Abhinaya-Restek-UNY/MainBoard-Transport-Unlimited2026/MainBoard_Unlimited26/MainBoard_Unlimited26A/MainBoard_Unlimited26A.kicad_pcb

## KiCad design MainBoard_Unlimited26/MainBoard_Unlimited26A/MainBoard_Unlimited26A.kicad_pcb (2026-07-16)

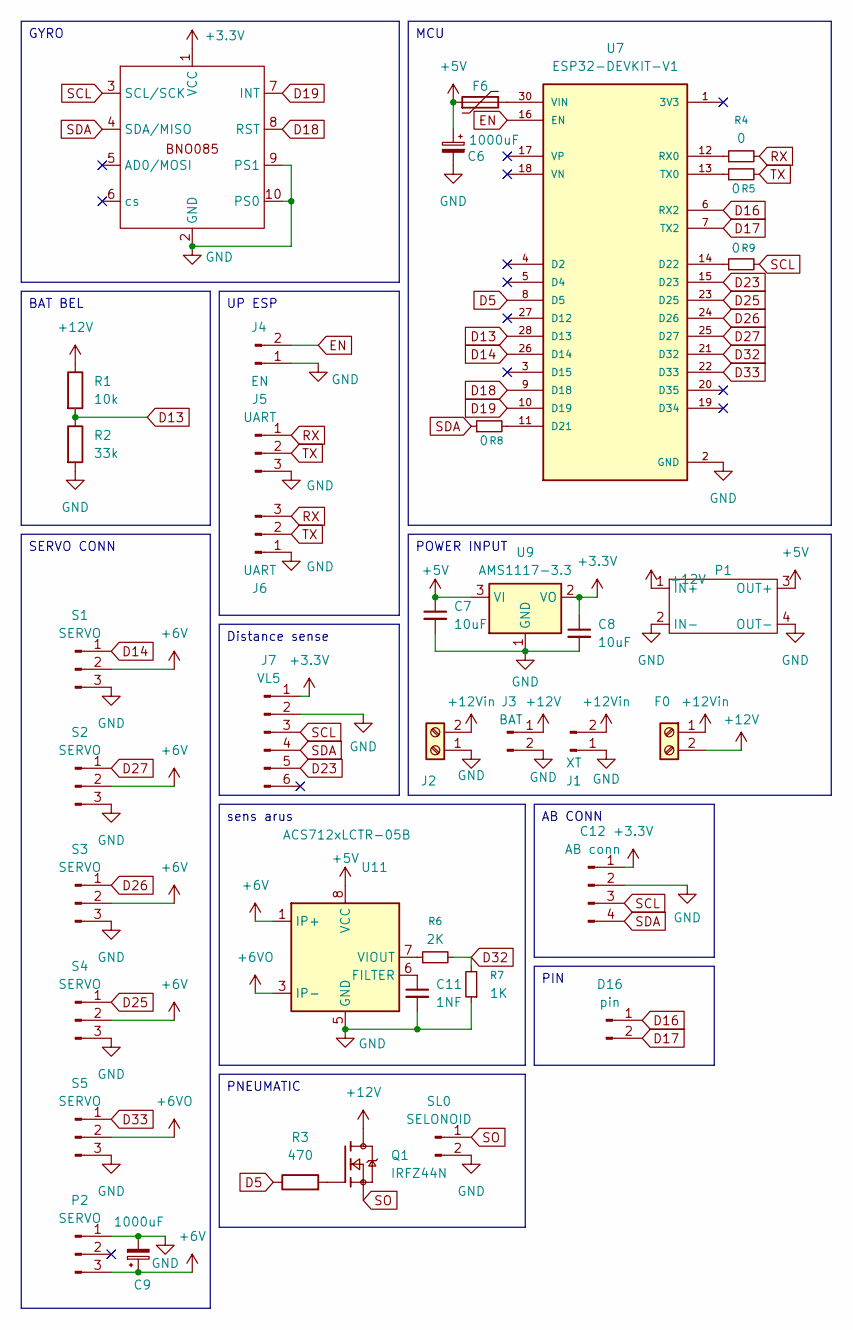
[picture p1: schematic MainBoard_Unlimited26A.kicad_sch]

Parts:
C6, C9: 1000uF; CP_Radial_D10.0mm_P5.00mm
C7, C8: 10uF; C_0805_2012Metric_Pad1.18x1.45mm_HandSolder
C11: 1NF; C_0805_2012Metric_Pad1.18x1.45mm_HandSolder
C12: AB conn; JST_XH_S4B-XH-A-1_1x04_P2.50mm_Horizontal
D16: pin; PinHeader_1x02_P2.54mm_Vertical
F0: Screw_Terminal_01x02; TerminalBlock_MaiXu_MX126-5.0-02P_1x02_P5.00mm
F6: Polyfuse; Fuse_1812_4532Metric
J1: XT; AMASS_XT60-M_1x02_P7.20mm_Vertical
J2: Screw_Terminal_01x02; TerminalBlock_MaiXu_MX126-5.0-02P_1x02_P5.00mm
J3: BAT; JST_XH_B2B-XH-A_1x02_P2.50mm_Vertical
J4: EN; PinHeader_1x02_P2.54mm_Horizontal
J5: UART; PinHeader_1x03_P2.54mm_Horizontal
J6: UART; JST_XH_S3B-XH-A_1x03_P2.50mm_Horizontal
J7: VL5; JST_XH_B6B-XH-A_1x06_P2.50mm_Vertical
P1: MP1584_Module
P2: SERVO; JST_XH_B3B-XH-A_1x03_P2.50mm_Vertical
Q1: IRFZ44N; TO254P1016X419X2286-3; PARTREV 09/21/10
R1: 10k; R_1206_3216Metric_Pad1.30x1.75mm_HandSolder
R2: 33k; R_0805_2012Metric_Pad1.20x1.40mm_HandSolder
R3: 470; R_1206_3216Metric_Pad1.30x1.75mm_HandSolder
R4, R5, R8, R9: 0; R_1206_3216Metric_Pad1.30x1.75mm_HandSolder
R6: 2K; R_0805_2012Metric_Pad1.20x1.40mm_HandSolder
R7: 1K; R_0805_2012Metric_Pad1.20x1.40mm_HandSolder
S1, S2, S3, S4, S5: SERVO; JST_XH_B3B-XH-A_1x03_P2.50mm_Vertical
SL0: SELONOID; JST_XH_B2B-XH-A_1x02_P2.50mm_Vertical
U7: ESP32-DEVKIT-V1; MODULE_ESP32_DEVKIT_V1; PARTREV N/A
U8: MPU6050/BNO085 I2C; PinSocket_1x10_P2.54mm_Vertical
U9: AMS1117-3.3; SOT-223-3_TabPin2
U11: ACS712xLCTR-05B; SOIC-8_3.9x4.9mm_P1.27mm

Connections:
+3.3V: C8.1, C12.1, J7.1, U8.1 (VCC), U9.2 (VO)
+5V: C6.1, C7.1, F6.1, P1.3 (OUT+), U9.3 (VI), U11.8 (VCC)
+6V: C9.1, P2.3, S1.2, S2.2, S3.2, S4.2, U11.1 (IP+), U11.2 (IP+)
+6VO: S5.2, U11.3 (IP-), U11.4 (IP-)
+12V: F0.2, J3.1, P1.1 (IN+), Q1.2, R1.1
+12Vin: F0.1, J1.2, J2.2
D5: R3.1, U7.8 (D5)
D13: R1.2, R2.1, U7.28 (D13)
D14: S1.1, U7.26 (D14)
D16: D16.1, U7.6 (RX2)
D17: D16.2, U7.7 (TX2)
D18: U7.9 (D18), U8.8 (RST)
D19: U7.10 (D19), U8.7 (INT)
D23: J7.5, U7.15 (D23)
D25: S4.1, U7.23 (D25)
D26: S3.1, U7.24 (D26)
D27: S2.1, U7.25 (D27)
D32: R6.2, R7.2, U7.21 (D32)
D33: S5.1, U7.22 (D33)
EN: J4.2, U7.16 (EN)
GND: C6.2, C7.2, C8.2, C9.2, C11.2, C12.2, J1.1, J2.1, J3.2, J4.1, J5.3, J6.1, J7.2, P1.2 (IN-), P1.4 (OUT-), P2.1, R2.2, R7.1, S1.3, S2.3, S3.3, S4.3, S5.3, SL0.2, U7.2 (GND), U7.29 (GND), U8.2 (GND), U8.9 (PS1), U8.10 (PS0), U9.1 (GND), U11.5 (GND)
unnamed: Q1.1, R3.2
unnamed: R8.2, U7.11 (D21)
unnamed: R9.1, U7.14 (D22)
unnamed: R4.1, U7.12 (RX0)
unnamed: R5.1, U7.13 (TX0)
unnamed: F6.2, U7.30 (VIN)
unnamed: C11.1, U11.6 (FILTER)
unnamed: R6.1, U11.7 (VIOUT)
RX: J5.1, J6.3, R4.2
SCL: C12.3, J7.3, R9.2, U8.3 (SCL/SCK)
SDA: C12.4, J7.4, R8.1, U8.4 (SDA/MISO)
SO: Q1.3, SL0.1
TX: J5.2, J6.2, R5.2

Notes on the sheet:
AB CONN
PIN
UP ESP
PNEUMATIC
sens arus
POWER INPUT
MCU
BAT BEL
Distance sense
GYRO
SERVO CONN

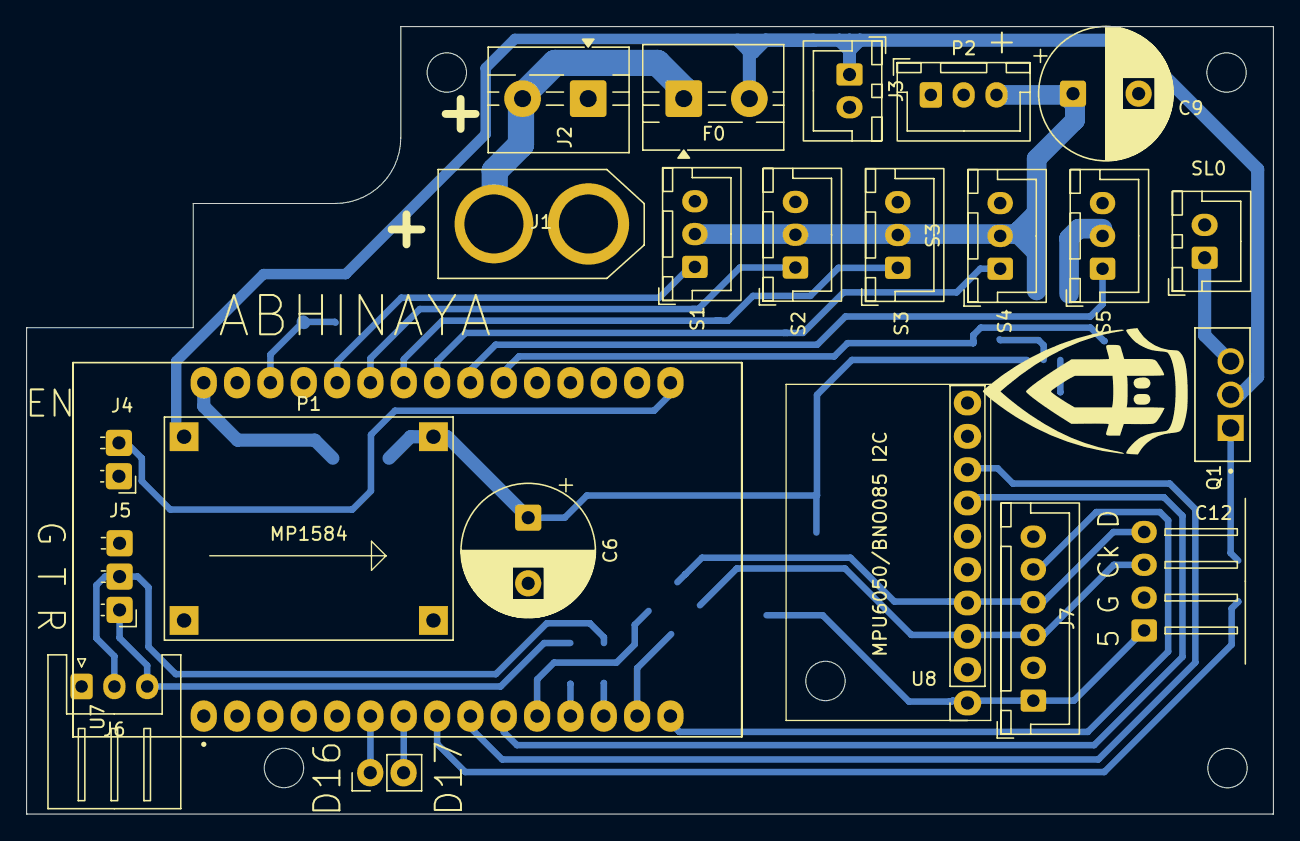
[picture p2: board MainBoard_Unlimited26A.kicad_pcb from above]

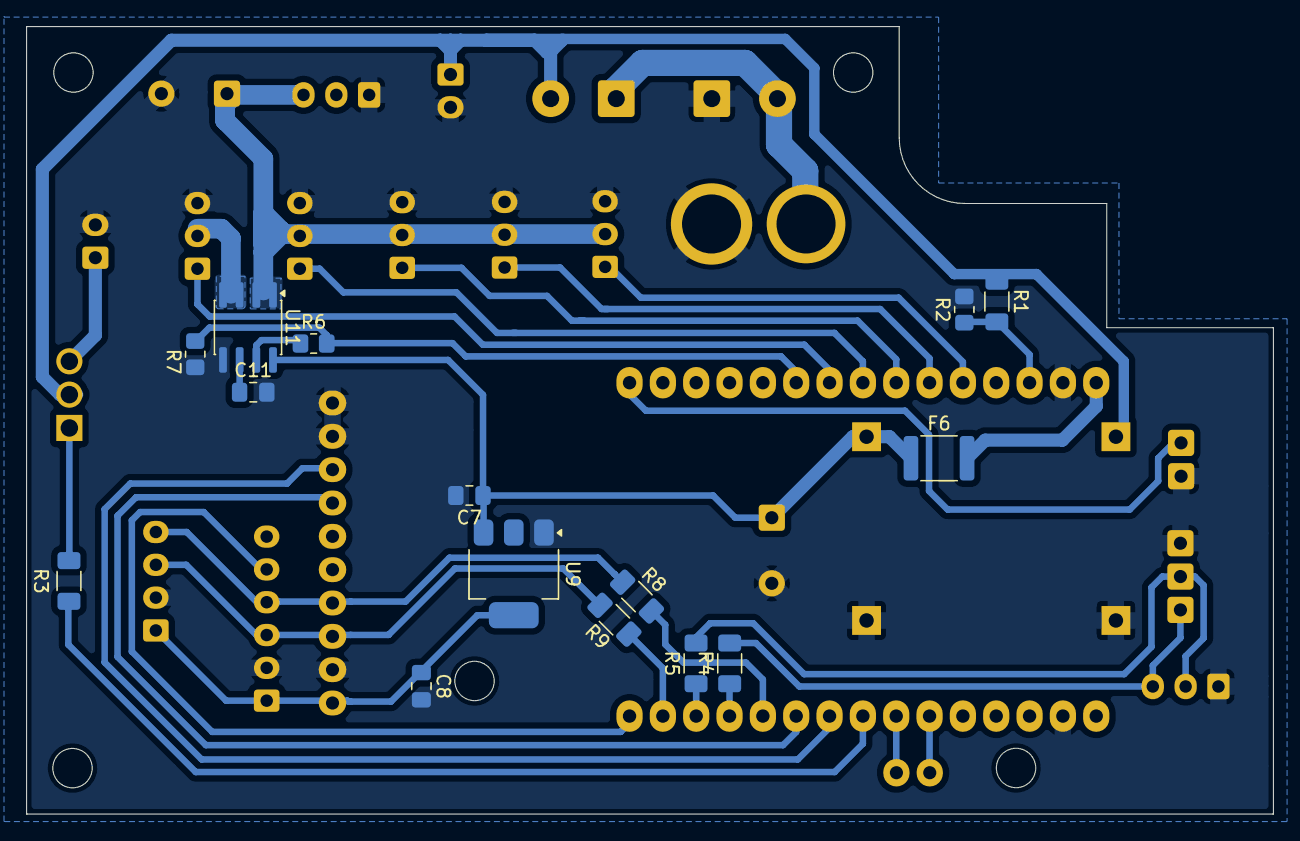
[picture p3: board MainBoard_Unlimited26A.kicad_pcb from below]

Board: 2 copper layers, 95.0 x 60.0 mm, 38 parts (15 on the bottom side), 34 nets.
