Abhinaya-Restek-UNY/MainBoard-Transport-Unlimited2026/MainBoard_Unlimited26/MainBoard_Unlimited26B/MainBoard_Unlimited26B.kicad_pcb

## KiCad design MainBoard_Unlimited26/MainBoard_Unlimited26B/MainBoard_Unlimited26B.kicad_pcb (2026-07-16)

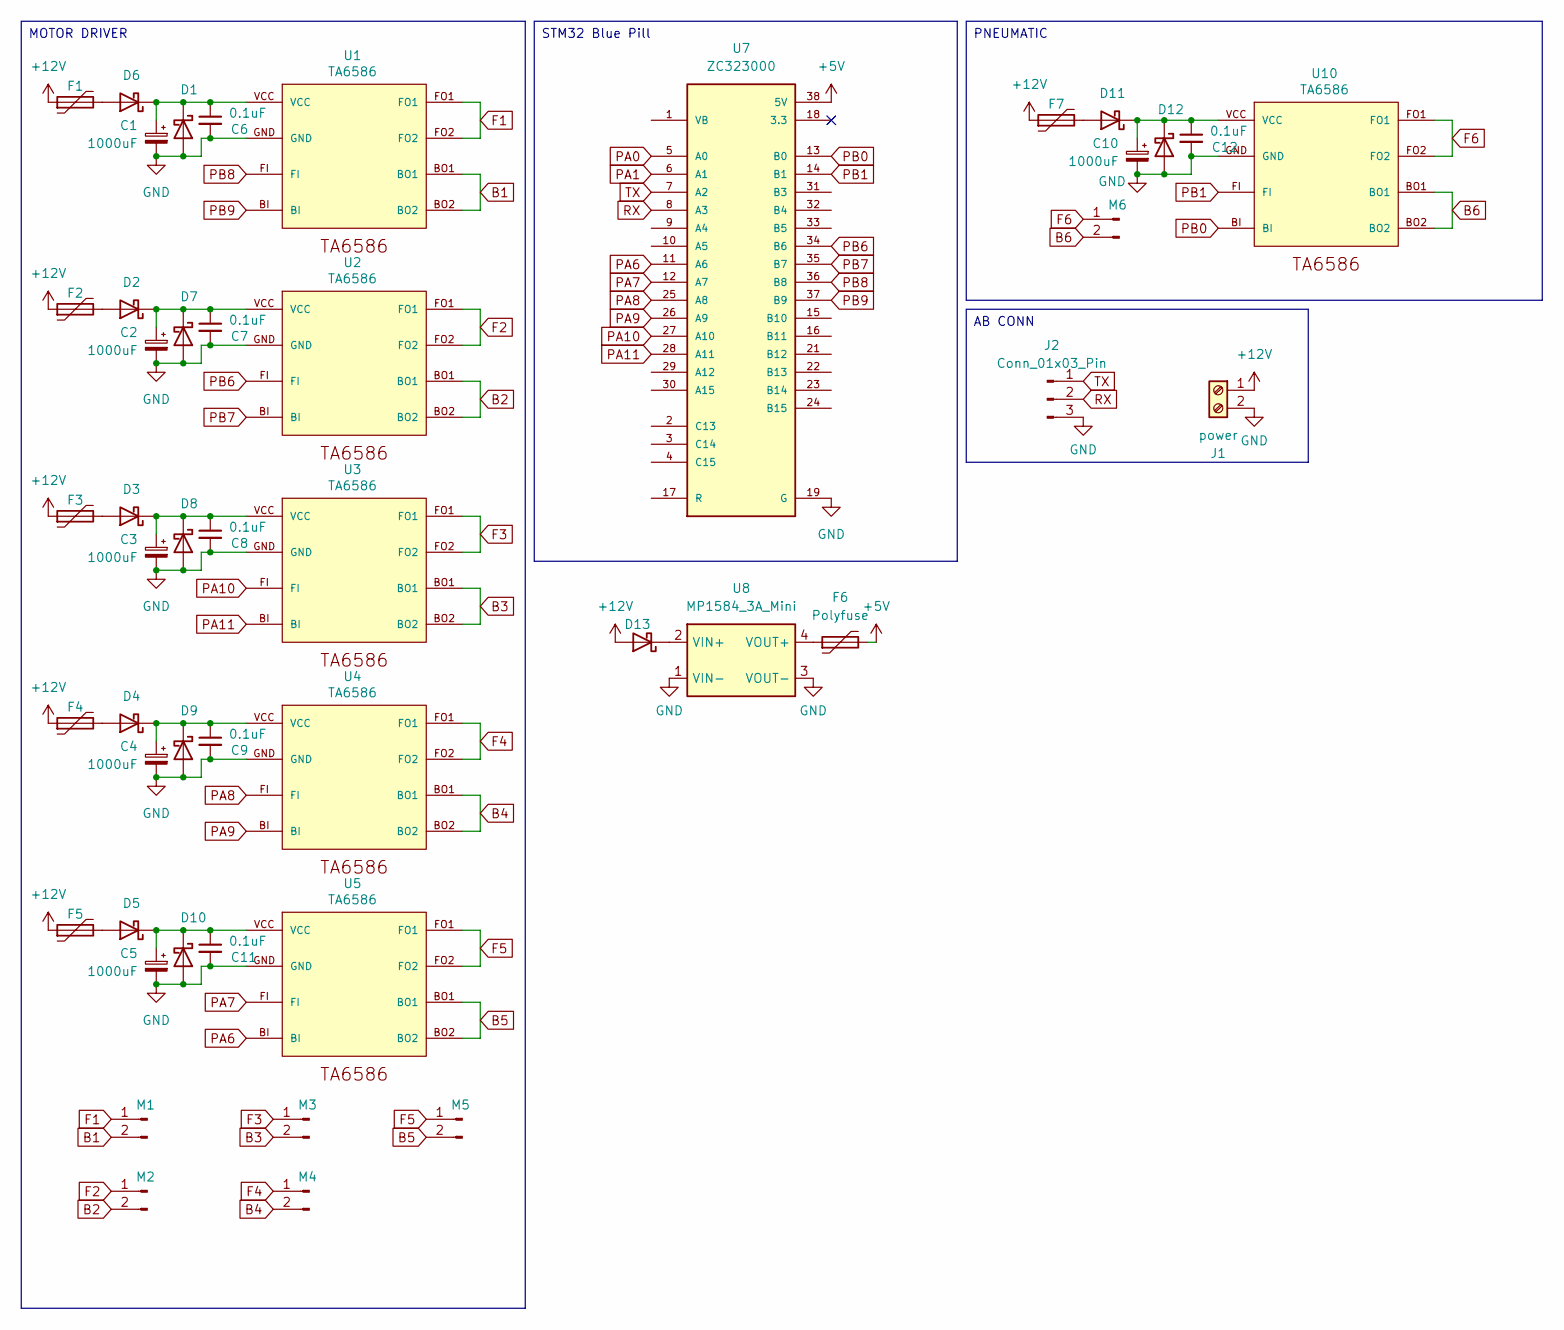
[picture p4: schematic MainBoard_Unlimited26B.kicad_sch]

Parts:
C1, C2, C3, C4, C5, C10: 1000uF; CP_Radial_D10.0mm_P5.00mm
C6, C7, C8, C9, C11, C12: 0.1uF; C_0805_2012Metric_Pad1.18x1.45mm_HandSolder
D1, D2, D3, D4, D5, D6, D7, D8, D9, D10, D11, D12, D13: D_Schottky; D_SMA
F1, F2, F3, F4, F5, F7: Polyfuse; Fuse_Bourns_MF-RG300
F6: Polyfuse; Fuse_1812_4532Metric
J1: power; TE_282815-2
J2: Conn_01x03_Pin; JST_XH_B3B-XH-A_1x03_P2.50mm_Vertical
M1, M2, M3, M4, M5, M6: JST_XH_S2B-XH-A-1_1x02_P2.50mm_Horizontal
U1, U2, U3, U4, U5, U10: TA6586; TA6586-FOOTPRINT
U7: ZC323000; MODULE_ZC323000; PARTREV N/A
U8: MP1584_3A_Mini; Mini360

Connections:
+5V: F6.2, U7.38 (5V)
+12V: D13.2 (A), F1.1, F2.1, F3.1, F4.1, F5.1, F7.1, J1.1
B1: M1.2, U1.BO1, U1.BO2
B2: M2.2, U2.BO1, U2.BO2
B3: M3.2, U3.BO1, U3.BO2
B4: M4.2, U4.BO1, U4.BO2
B5: M5.2, U5.BO1, U5.BO2
B6: M6.2, U10.BO1, U10.BO2
F1: M1.1, U1.FO1, U1.FO2
F2: M2.1, U2.FO1, U2.FO2
F3: M3.1, U3.FO1, U3.FO2
F4: M4.1, U4.FO1, U4.FO2
F5: M5.1, U5.FO1, U5.FO2
F6: M6.1, U10.FO1, U10.FO2
GND: C1.2, C2.2, C3.2, C4.2, C5.2, C6.2, C7.2, C8.2, C9.2, C10.2, C11.2, C12.2, D1.2 (A), D7.2 (A), D8.2 (A), D9.2 (A), D10.2 (A), D12.2 (A), J1.2, J2.3, U1.GND, U2.GND, U3.GND, U4.GND, U5.GND, U7.19 (G), U7.20 (G), U7.39 (G), U8.1 (VIN-), U8.3 (VOUT-), U10.GND
unnamed: C1.1, C6.1, D1.1 (K), D6.1 (K), U1.VCC
unnamed: D2.2 (A), F2.2
unnamed: C2.1, C7.1, D2.1 (K), D7.1 (K), U2.VCC
unnamed: D3.2 (A), F3.2
unnamed: C3.1, C8.1, D3.1 (K), D8.1 (K), U3.VCC
unnamed: D4.2 (A), F4.2
unnamed: C4.1, C9.1, D4.1 (K), D9.1 (K), U4.VCC
unnamed: D5.2 (A), F5.2
unnamed: D6.2 (A), F1.2
unnamed: C5.1, C11.1, D5.1 (K), D10.1 (K), U5.VCC
unnamed: D11.2 (A), F7.2
unnamed: C10.1, C12.1, D11.1 (K), D12.1 (K), U10.VCC
unnamed: D13.1 (K), U8.2 (VIN+)
unnamed: F6.1, U8.4 (VOUT+)
PA0: U7.5 (A0)
PA1: U7.6 (A1)
PA6: U5.BI, U7.11 (A6)
PA7: U5.FI, U7.12 (A7)
PA8: U4.FI, U7.25 (A8)
PA9: U4.BI, U7.26 (A9)
PA10: U3.FI, U7.27 (A10)
PA11: U3.BI, U7.28 (A11)
PB0: U7.13 (B0), U10.BI
PB1: U7.14 (B1), U10.FI
PB6: U2.FI, U7.34 (B6)
PB7: U2.BI, U7.35 (B7)
PB8: U1.FI, U7.36 (B8)
PB9: U1.BI, U7.37 (B9)
RX: J2.2, U7.8 (A3)
TX: J2.1, U7.7 (A2)

Notes on the sheet:
PNEUMATIC
AB CONN
MOTOR DRIVER
STM32 Blue Pill

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
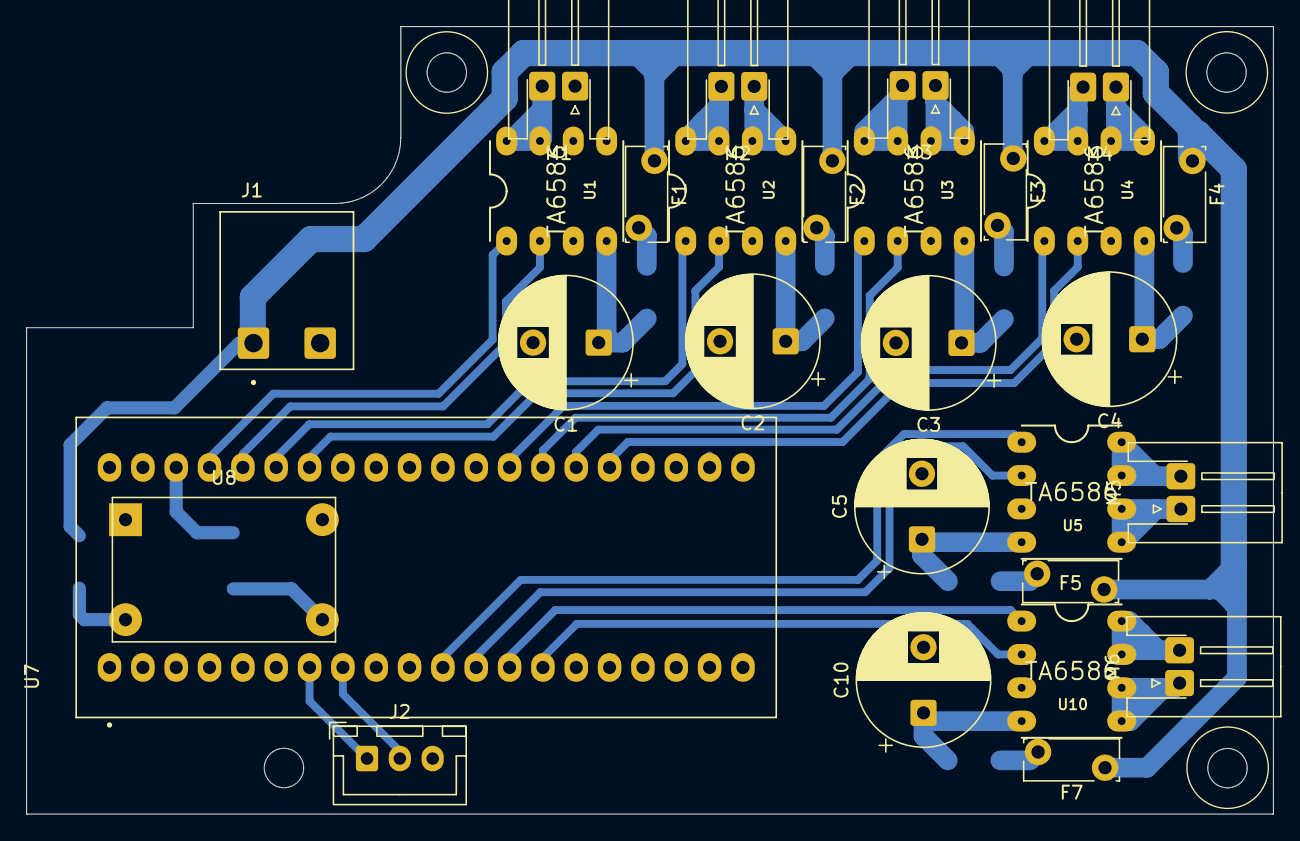
[picture p5: board MainBoard_Unlimited26B.kicad_pcb from above]

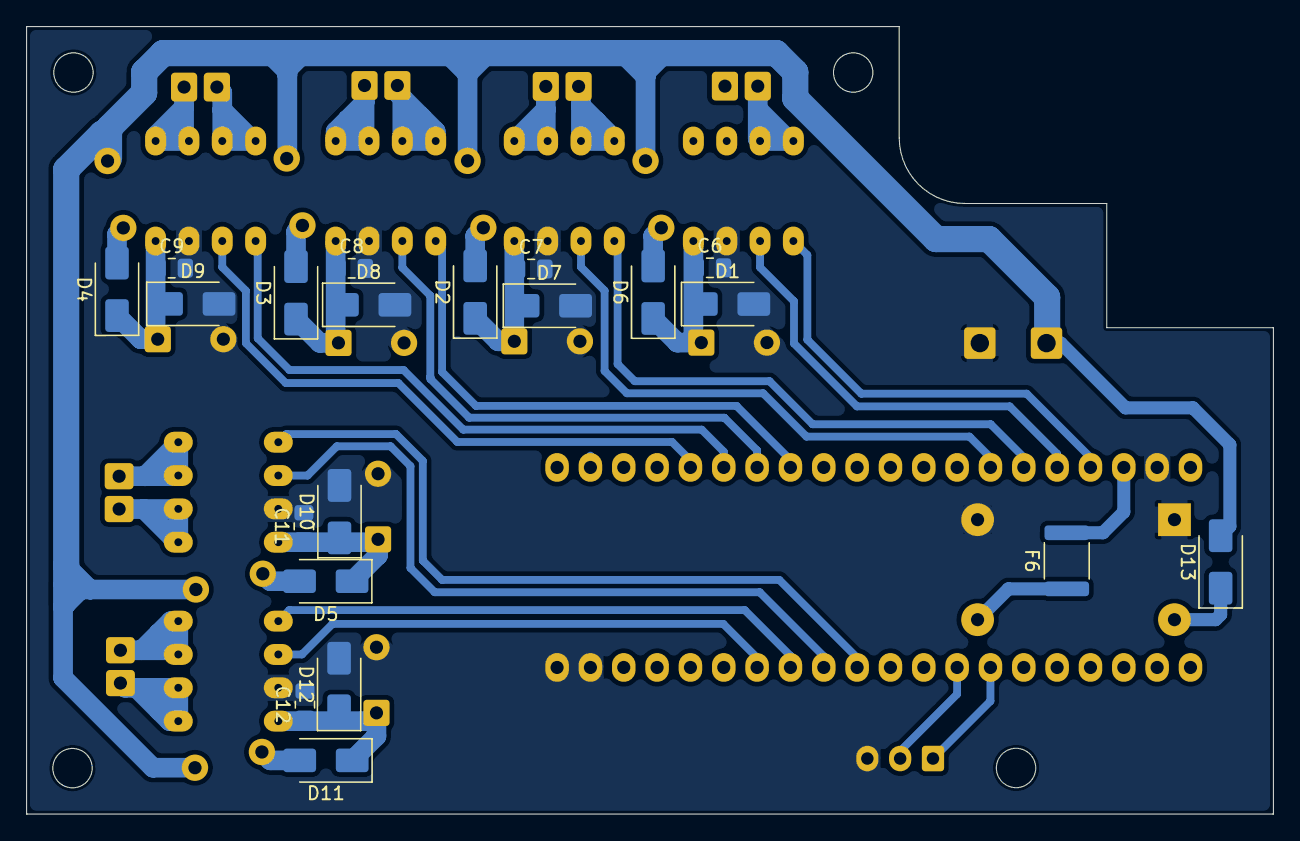
[picture p6: board MainBoard_Unlimited26B.kicad_pcb from below]

Board: 2 copper layers, 95.0 x 60.0 mm, 48 parts (20 on the bottom side), 43 nets.
