Abhinaya-Restek-UNY/MainBoard-Transport-Unlimited2026/esp32-cam_holder/esp32-cam_holder.kicad_pcb

## KiCad design esp32-cam_holder/esp32-cam_holder.kicad_pcb (2026-07-10)

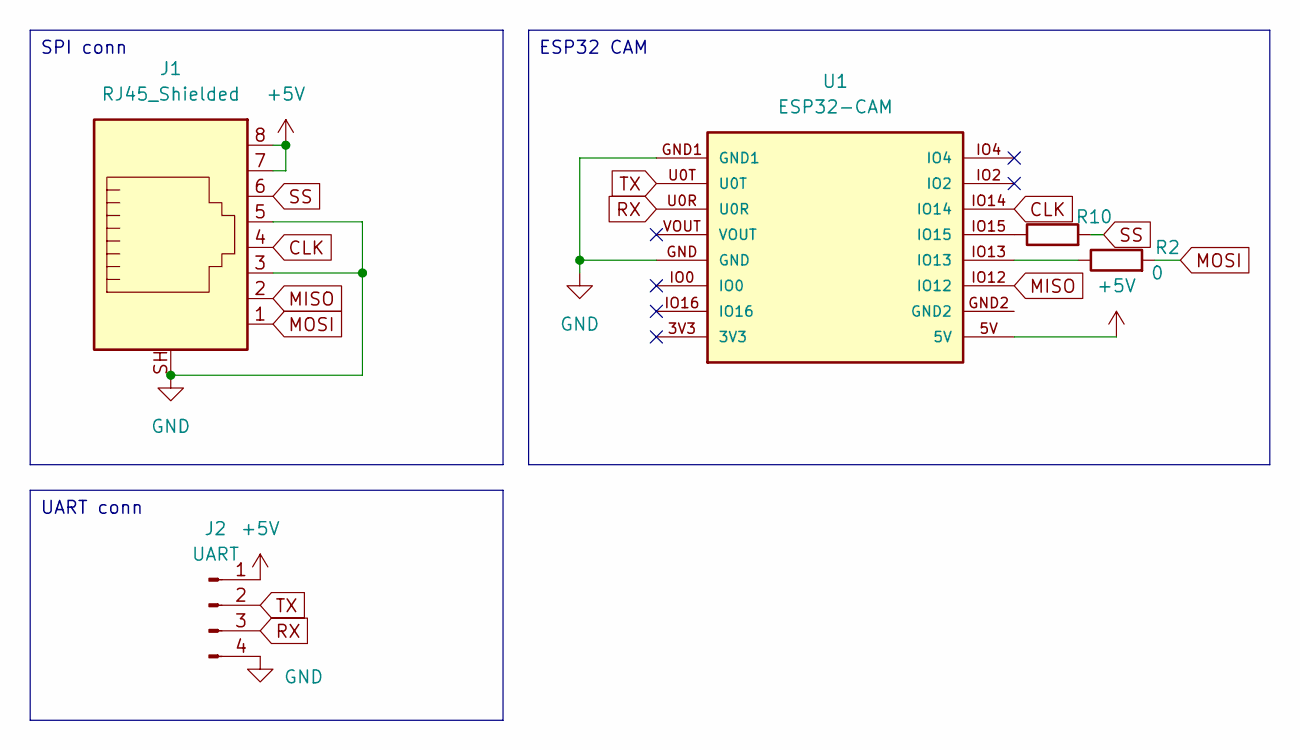
[picture p7: schematic esp32-cam_holder.kicad_sch]

Parts:
J1: RJ45_Shielded; RJ45_Amphenol_RJHSE5380
J2: UART; PinHeader_1x04_P2.54mm_Horizontal
R1, R2: 0; R_1206_3216Metric_Pad1.30x1.75mm_HandSolder
U1: ESP32-CAM

Connections:
+5V: J1.7, J1.8, J2.1, U1.5V
CLK: J1.4, U1.IO14
GND: J1.3, J1.5, J1.SH, J2.4, U1.GND, U1.GND1
MISO: J1.2, U1.IO12
MOSI: J1.1, R2.2
unnamed: R1.1, U1.IO15
unnamed: R2.1, U1.IO13
RX: J2.3, U1.U0R
SS: J1.6, R1.2
TX: J2.2, U1.U0T

Notes on the sheet:
ESP32 CAM
SPI conn
UART conn

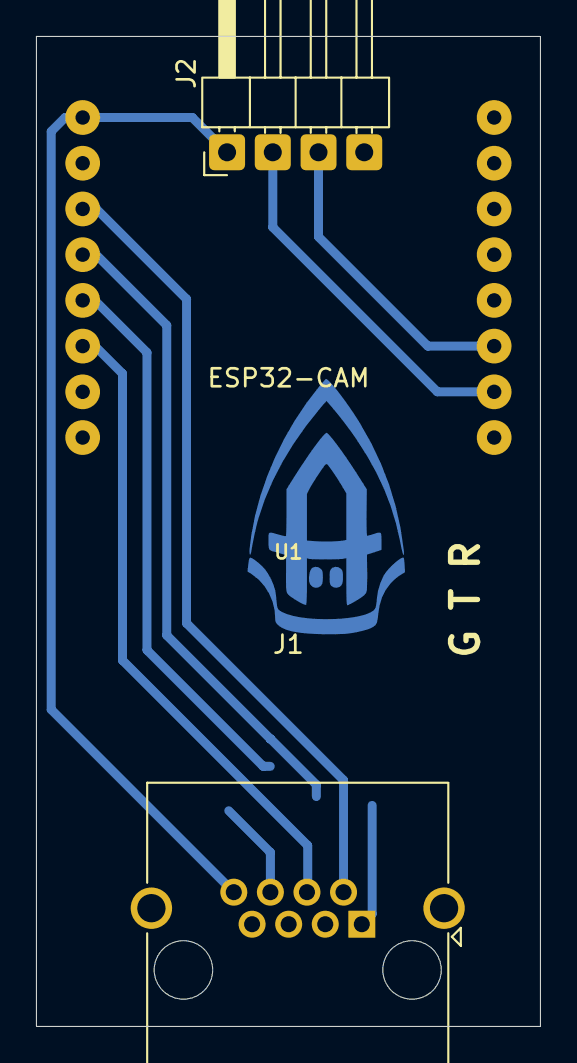
[picture p8: board esp32-cam_holder.kicad_pcb from above]

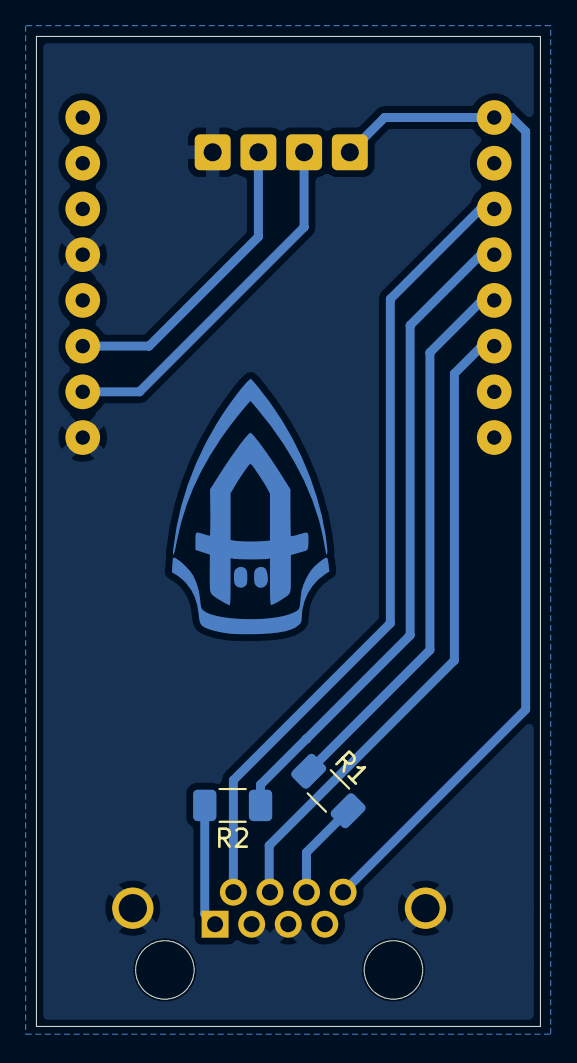
[picture p9: board esp32-cam_holder.kicad_pcb from below]

Board: 2 copper layers, 28.0 x 55.0 mm, 5 parts (2 on the bottom side), 10 nets.
