Abhinaya-Restek-UNY/MainBoard-Transport-Unlimited2026/(commit log)

2026-07-03 add PCB design
    [MainBoardTrans_Unlimited2026.kicad_pcb, MainBoardTrans_Unlimited2026.kicad_sch]
2026-07-04 add pin
    [List pin Trans_Unlimited2026.xlsx]
2026-07-04 update pcb
    [MainBoardTrans_Unlimited2026.kicad_pcb, MainBoardTrans_Unlimited2026.kicad_sch]
2026-07-13 update lagi
    [List pin Trans_Unlimited2026.xlsx, MainBoardTrans_Unlimited2026.kicad_pcb, MainBoardTrans_Unlimited2026.kicad_sch, MainBoard_Station_Unlimited2026.kicad_pcb, MainBoard_Station_Unlimited2026.kicad_sch, MainBoard_Unlimited2026.kicad_pcb, MainBoard_Unlimited2026.kicad_sch, MainBoard_Unlimited26A.kicad_pcb]
2026-07-16 add pin list
2026-07-23 Update Pin Robot Transporter.md
